IHP-GmbH/TO_Dec2024/README.md

## Sample request process

The December 2024 run is out of the fab, so you can now ask for samples.

### What you must do

1. Sign the Hiring Agreement: [samples.rtf](https://github.com/IHP-GmbH/TO_Sep2025/blob/main/drc/samples.rtf) (download i
2. Send the signed file by email to:
   - **herman(at)ihp-microelectronics.com**
   - **nkehder(at)ihp-microelectronics.com**

### Required data in your email

Please include all contact details:

- **Name Last Name**
- **Address**
- **Phone number**
- **Email**

### Packaging options and bonding plan

- By default, we send **10 bare dies**.
- If you need a packaged chip, we can offer **QFN** or **open QFN** with pin counts from **24 to 64**.
- For bonding, we need a bonding plan.

| Design name | Short one line description | Location directory |
| --- | --- | --- |
| Three SiGe HBT amplifiers (`FMD_QNC_amps_filled`) | Three SiGe HBT low-power amplifiers, a 3.3 V shunt regulator, and RF test structures on IHP SG13G2. | `RF_amplifiers/` |
