IHP-GmbH/TO_Dec2024/RF_amplifiers/doc/build/latex/pinout-eps-converted-to.pdf

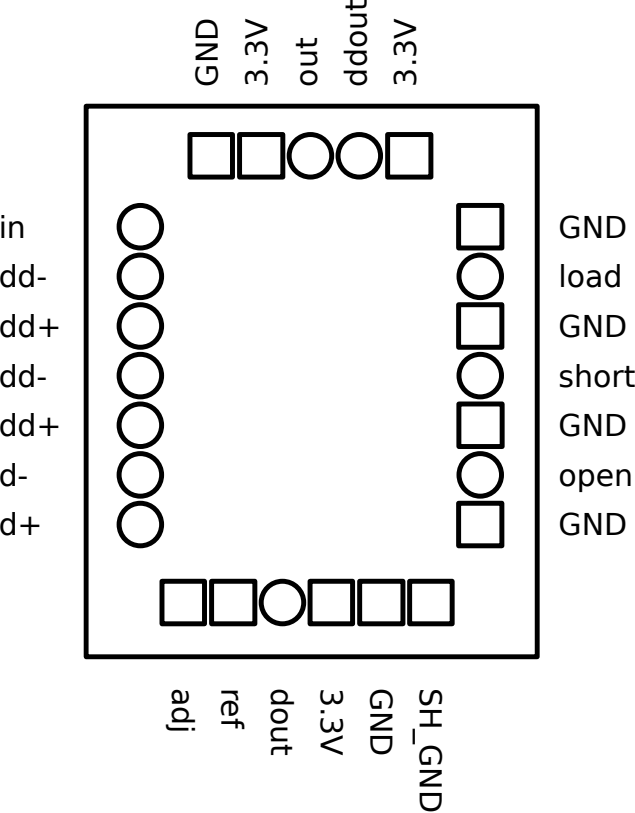
[picture p5: figure]
GND; load; short; open; out; ddout; adj; ref; dout; SH_GND
