IHP-GmbH/TO_Dec2024/RF_amplifiers/doc/source/_static/amplifiers_TB_xyce.pdf

/ALL/git_olisnr/TO_Dec2024/RF_amplifiers/design_data/xschem/amplifiers/amplifiers_TB_xyce.sch

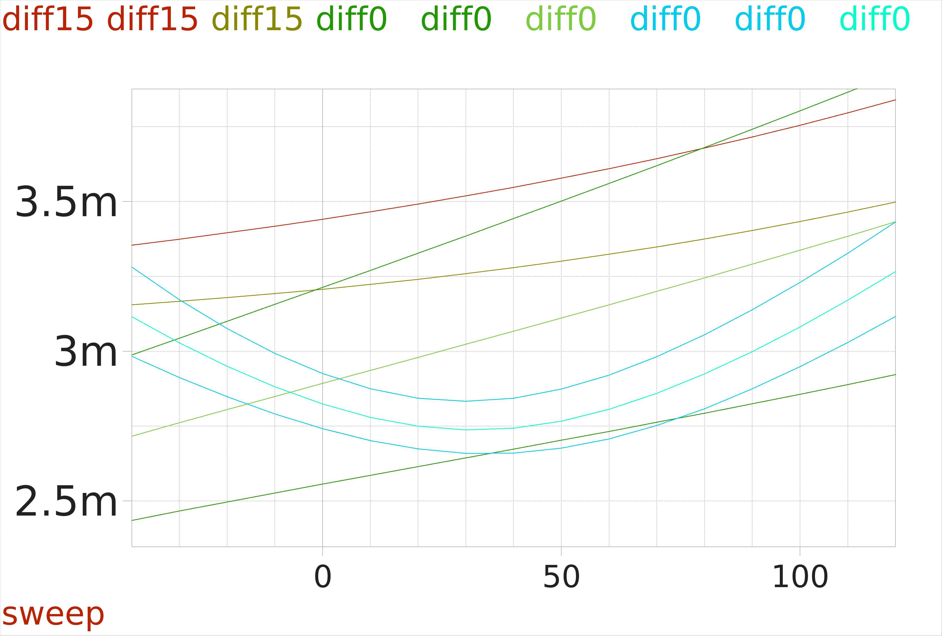
[picture p6: figure]

signal

VSS

VDD

GNDGND

GND

GND

0

h_single

GND

GND

signal

VDD

VSS

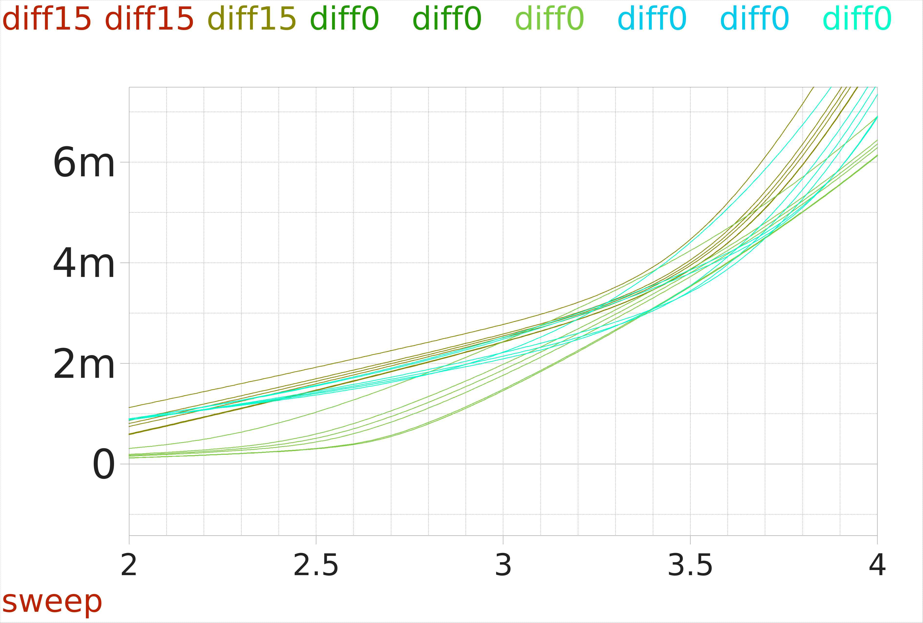
[picture p7: figure]

h_diff_0dB_cm

GND

signal

h_diff_0dB

GND

GND

signal

signal

VDD

VDD

VDD

VDD

VSS

VSS

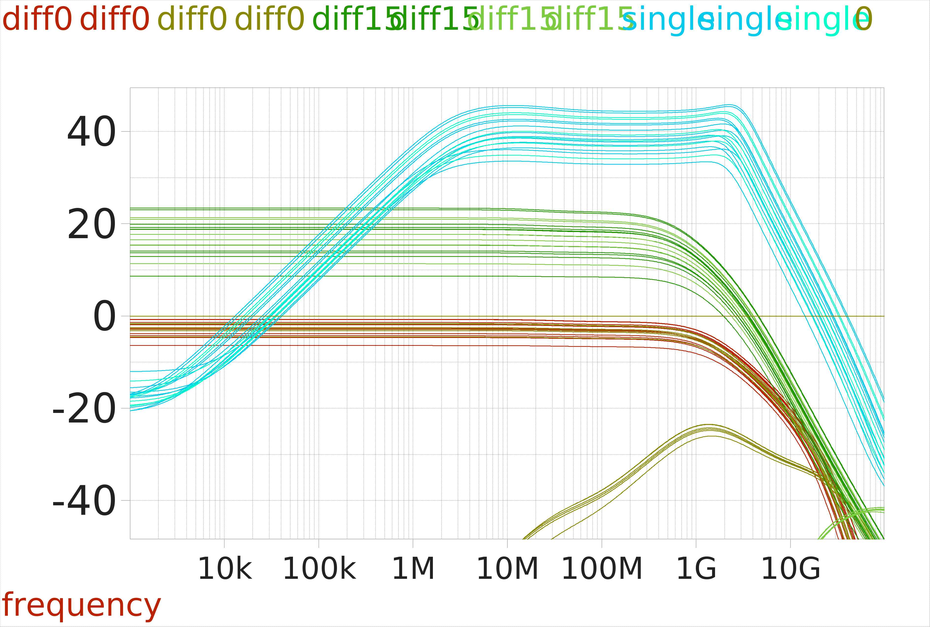
[picture p8: figure]

h_diff_15dB_cm

GND

signal

h_diff_15dB

GND

GND

signal

signal

VDD

VDD

VDD

VDD

VSS

VSS

VDD

/ALL/git_olisnr/TO_Dec2024/RF_amplifiers/design_data/xschem/amplifiers/amplifiers_TB_xyce.sch

om | 2024-12-14 23:22:29 SCHEM

VDD

3.3

VMINUS

0 pulse -100m 100m 1u 10n 10n 33u 66u ac 1 0

VSS

0

COMMANDS1

pdk_path = /home/ich/share/pdk/ihp-sg13g2

mosfet corners: tt ss ff sf fs
mosfet corners: tt
hbt corners: wcs typ bcs

simulations: op dc dc_zoom ac tran simulations: op dc ac temp

ac 1003..100e9Hz;

# pmos w/l = 2u/1u dont work for TCL # nmos w/l = 1u/1u dont work for TCL pmos w/l = 2e-6/1e-6

nmos w/l = 1e-6/1e-6

#proc to ignore simulator=none evaluation for ngspice

.raw-file path and namebase: /ALL/git_olisnr/TO_Dec2024/RF_amplifiers/design_data/xschem/amplifiers/simulation/amplifiers_TB_xyce

SIM=none

NGSPiCE TCL
SIM=ngspice

### load waves

* schematic: amplifiers_TB_xyce
* dir: | /ALL/git_olisnr/TO_Dec2024/RF_amplifiers/design_data/xschem/amplifiers
* test: | /ALL/git_olisnr/TO_Dec2024/RF_amplifiers/design_data/xschem/amplifiers/OTA33_BiAS.sym
.lib /home/ich/share/pdk/ihp-sg13g2/libs.tech/xyce/models/cornerRES.lib | res_typ
.lib /home/ich/share/pdk/ihp-sg13g2/libs.tech/xyce/models/cornerCAP.lib | cap_typ
.lib /home/ich/share/pdk/ihp-sg13g2/libs.tech/xyce/models/cornerMOShv.lib | mos_tt
.lib /home/ich/share/pdk/ihp-sg13g2/libs.tech/xyce/models/cornerMOSlv.lib | mos_tt
.lib /home/ich/share/pdk/ihp-sg13g2/libs.tech/xyce/models/cornerHBT.lib | hbt_bcs

.print dc format=raw v(*) i(*)

Xyce TCL
SIM=xyce

Vzero

0

### xyce netlist simulate corners ALL

Xyce
SIM=xyce

### xschem annotate_op

/ALL/git_olisnr/TO_Dec2024/RF_amplifiers/design_data/xschem/amplifiers/H_SiNGLE.sch

x12

VDD

ip

in

VSS

nmos: 1e-06/1e-06

pmos: 2e-06/1e-06sink #net1#net4
h_single

#net2

#net5

#net3

CGND

vGND
#net29

I12
{iset}

1

E5

Vsingle

Vsingle_all

/ALL/git_olisnr/TO_Dec2024/RF_amplifiers/design_data/xschem/amplifiers/DiFF_0dBdB.sch

x1

VDD

ip

in

VSS

nmos: 1e-06/1e-06

pmos: 2e-06/1e-06sink #net6#net14
h_diff_0dB_cm

#net9

#net9

#net13

CGND

vGND
#net30

I1
{iset}

/ALL/git_olisnr/TO_Dec2024/RF_amplifiers/design_data/xschem/amplifiers/DiFF_0dBdB.sch

x2

VDD

ip

in

VSS

nmos: 1e-06/1e-06

pmos: 2e-06/1e-06sink #net7#net15
h_diff_0dB

#net8

#net16

#net12

CGND

vGND
#net31

I2
{iset}

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
VLD1

1.65

VLD2

1.65

Vdiff0

Vmeas2

Vmeas3

Vdiff0_all

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
/ALL/git_olisnr/TO_Dec2024/RF_amplifiers/design_data/xschem/amplifiers/H_DiFF_15dB.sch

x3

VDD

ip

in

VSS

nmos: 1e-06/1e-06

pmos: 2e-06/1e-06sink #net17#net25
h_diff_15dB_cm

#net20

#net20

#net24

CGND

vGND
#net32

I3
{iset}

/ALL/git_olisnr/TO_Dec2024/RF_amplifiers/design_data/xschem/amplifiers/H_DiFF_15dB.sch

x4

VDD

ip

in

VSS

nmos: 1e-06/1e-06

pmos: 2e-06/1e-06sink #net18#net26
h_diff_15dB

#net19

#net27

#net23

CGND

vGND
#net33

I4
{iset}

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
VLD3

1.65

VLD4

1.65

Vdiff15

Vmeas6

Vmeas7

Vdiff15_all

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
VLD5

1.65

1

2

R9
50
m=1

loaded .raw files:
0 current
0 1 /ALL/git_olisnr/TO_Dec2024/RF_amplifiers/design_data/xschem/amplifiers/simulation/amplifiers_TB_xyce_ac_mostt_hbttyp.spice.raw ac 2 /ALL/git_olisnr/TO_Dec2024/RF_amplifiers/design_data/xschem/amplifiers/simulation/amplifiers_TB_xyce_ac_mostt_hbtwcs.spice.raw ac 3 /ALL/git_olisnr/TO_Dec2024/RF_amplifiers/design_data/xschem/amplifiers/simulation/amplifiers_TB_xyce_ac_mostt_hbtbcs.spice.raw ac 4 /ALL/git_olisnr/TO_Dec2024/RF_amplifiers/design_data/xschem/amplifiers/simulation/amplifiers_TB_xyce_dc_mostt_hbttyp.spice.raw dc
5 /ALL/git_olisnr/TO_Dec2024/RF_amplifiers/design_data/xschem/amplifiers/simulation/amplifiers_TB_xyce_temp_mostt_hbttyp.spice.raw dc 6 /ALL/git_olisnr/TO_Dec2024/RF_amplifiers/design_data/xschem/amplifiers/simulation/amplifiers_TB_xyce_temp_mostt_hbtbcs.spice.raw dc 7 /ALL/git_olisnr/TO_Dec2024/RF_amplifiers/design_data/xschem/amplifiers/simulation/amplifiers_TB_xyce_temp_mostt_hbtwcs.spice.raw dc
