IHP-GmbH/TO_Dec2024/RF_amplifiers/doc/source/index.rst

##########################################
Three SiGe HBT amplifiers
##########################################

.. warning::
    this chip is designed without correct LVS. only parts are really verified...

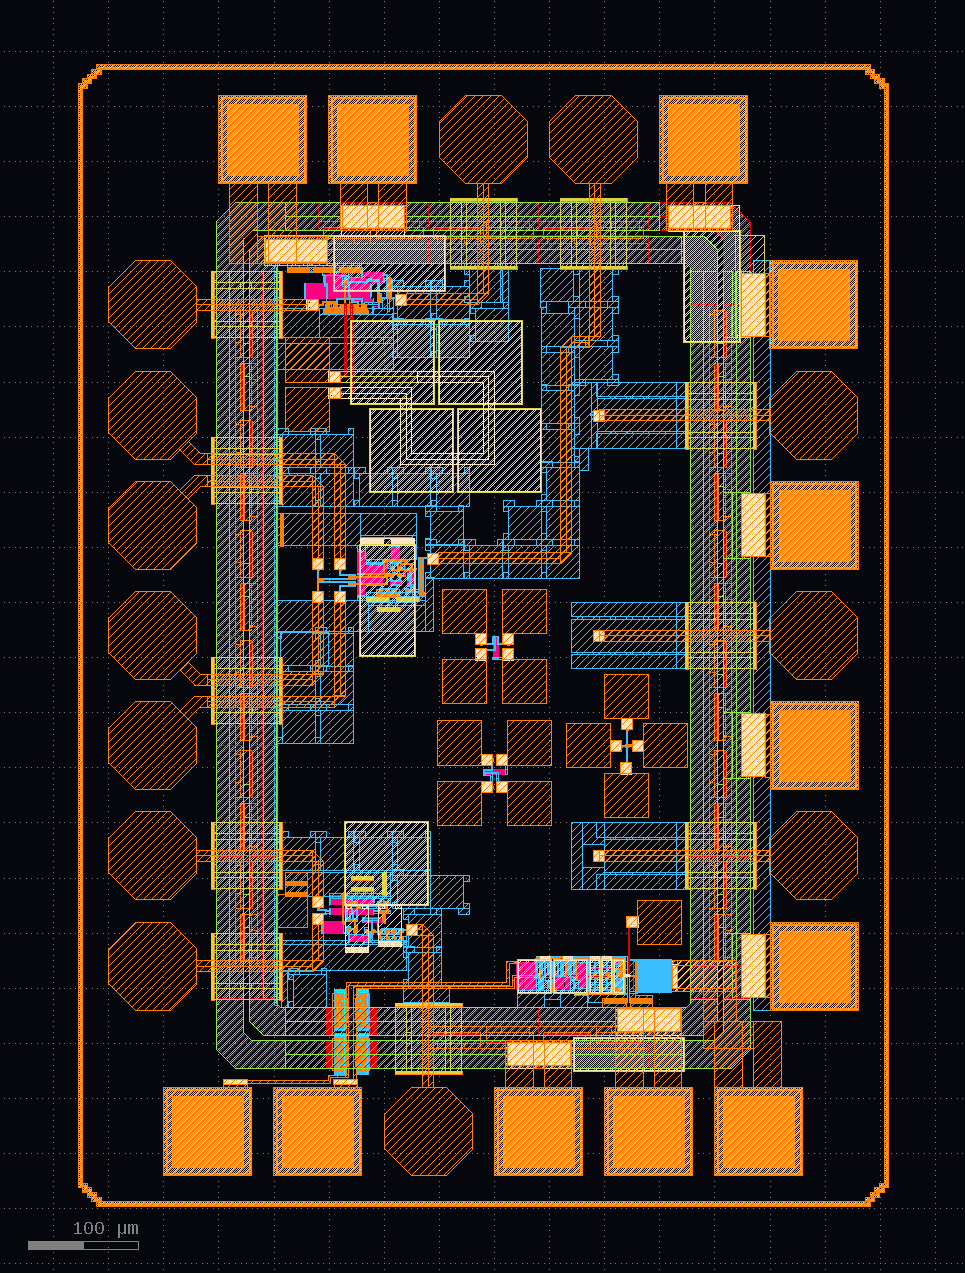
[picture p9: RF_amplifiers/doc/source/_static/chip.png]


\

.. toctree::
    :hidden:
    
    specification
    amplifiers
    regulator
    ota
    experiments
    designdata
    validation

.. only:: latex

    .. contents:: Table of Contents
