IHP-GmbH/TO_Dec2024/RF_amplifiers/doc/source/_static/SHUNT_3V1.pdf

# /ALL/git_olisnr/TO_Dec2024/RF_amplifiers/design_data/xschem/shunt_regulator/SHUNT_3V1.sch

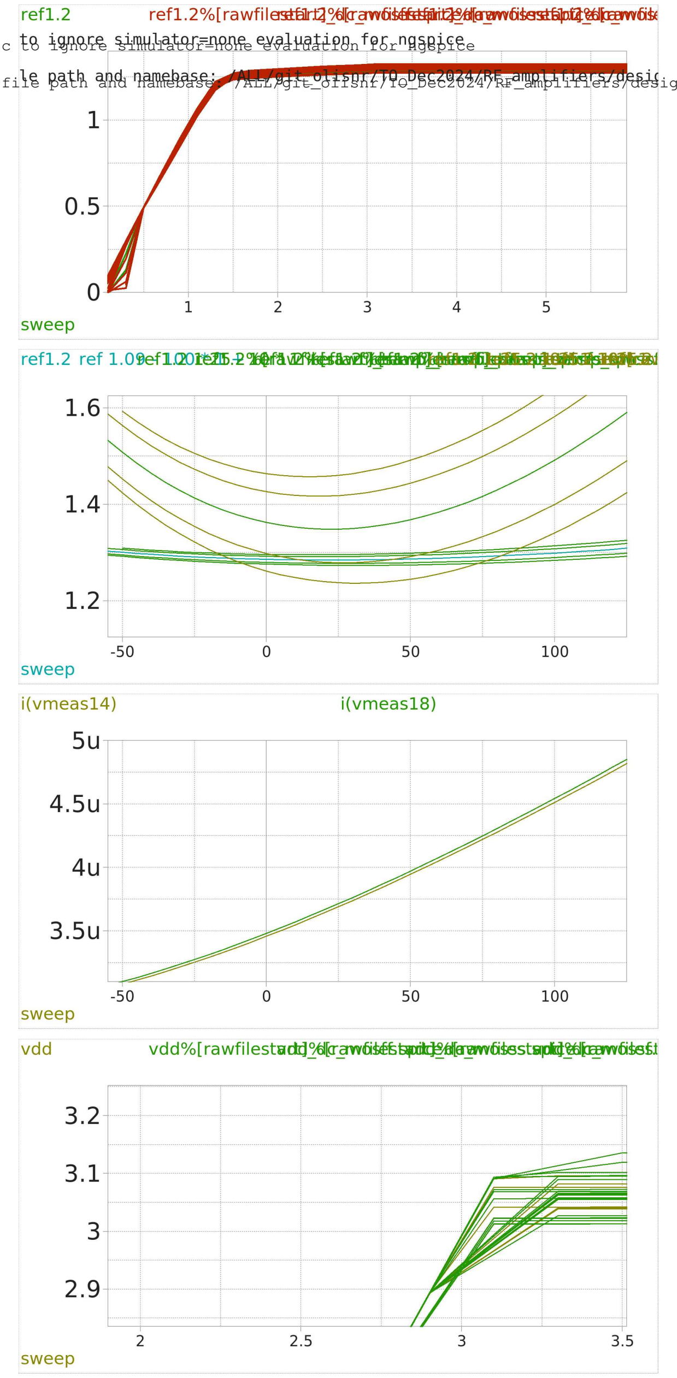
[picture p10: figure]
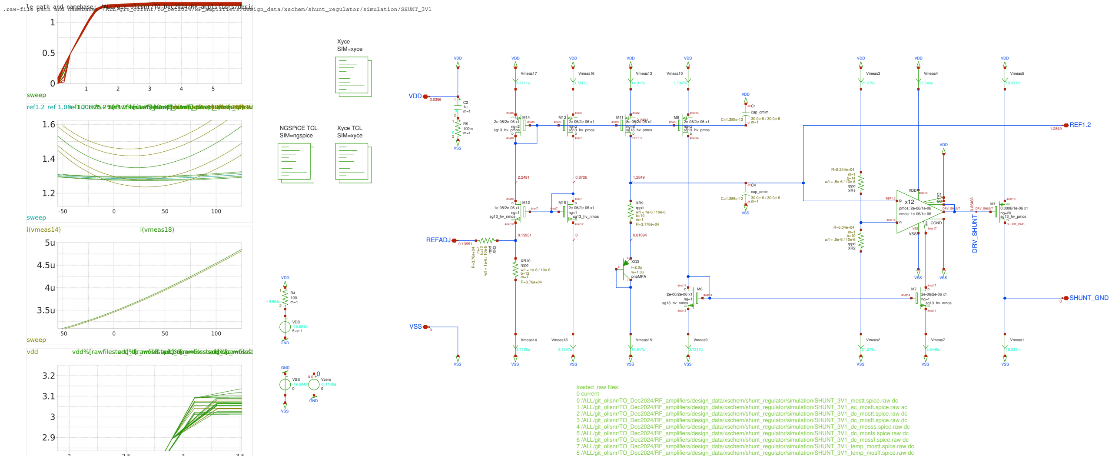
[picture p11: figure]
VSS; GND; VDD; VDDVDD; VSSVSS; DRV_SHUNT 0.85468; REFADJ; REF1.2; SHUNT_GND 0; .raw-file path and namebase: /ALL/git_olisnr/TO_Dec2024/RF_amplifiers/design_data/xschem/shunt_regulator/simulation/SHUNT_3V1; NGSPiCE TCL SIM=ngspice; Xyce TCL SIM=xyce; Vzero; Xyce SIM=xyce; Vmeas13; sg13_hv_pmos; #net2; #net8; Vmeas14; Vmeas15; pnpMPA; sg13_hv_nmos; #net10; #net7; #net5; #net6; Vmeas16; Vmeas17; Vmeas18; #net12; rppd; Vmeas7; #net17; #net11; #net14; Vmeas9; #net13; Vmeas10; #net15; SHUNT_GND; #net18; DRV_SHUNT; nmos: 1e-06/1e-06; pmos: 2e-06/1e-06sink #net17VSS; #net16; #net19; CGND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

### /ALL/git_olisnr/TO_Dec2024/RF_amplifiers/design_data/xschem/shunt_regulator/SHUNT_3V1.sch

om | 2024-12-14 23:22:29 SCHEM

COMMANDS1

amp schematics = /ALL/git_olisnr/TO_Dec2024/RF_amplifiers/design_data/xschem/shunt_regulator/hAMPsdiff_3.5mA_15dB.sch

pdk_path = /home/ich/share/pdk/ihp-sg13g2

mosfet corners: tt ss ff sf fs

simulations: op dc dc_zoom ac tran simulations: op dc ac temp

iset: 3u

ac 100e3..100e9Hz;

# pmos w/l = 2u/1u dont work for TCL # nmos w/l = 1u/1u dont work for TCL pmos w/l = 2e-6/1e-6

nmos w/l = 1e-6/1e-6

G = 33
Y = 11
A = 1
B = 1
C = 1

#proc to ignore simulator=none evaluation for ngspice

SIM=none

### load waves

COMMANDS3

spice code

* schematic: SHUNT_3V1
* dir: | /ALL/git_olisnr/TO_Dec2024/RF_amplifiers/design_data/xschem/shunt_regulator
* test: | /ALL/git_olisnr/TO_Dec2024/RF_amplifiers/design_data/xschem/shunt_regulator/OTA33_BiAS.sym

* mos_corner:
* mos_corner:

.option temp=27

.lib /home/ich/share/pdk/ihp-sg13g2/libs.tech/xyce/models/cornerRES.lib | res_typ
.lib /home/ich/share/pdk/ihp-sg13g2/libs.tech/xyce/models/cornerCAP.lib | cap_typ
.lib /home/ich/share/pdk/ihp-sg13g2/libs.tech/xyce/models/cornerMOShv.lib | mos_fs
.lib /home/ich/share/pdk/ihp-sg13g2/libs.tech/xyce/models/cornerMOSlv.lib | mos_fs
.lib /home/ich/share/pdk/ihp-sg13g2/libs.tech/xyce/models/cornerHBT.lib | hbt_typ

.param nw=1e-6
.param nl=1e-6
.param pw=2e-6
.param pl=1e-6
.param iset=3u

* .step dec iset 10u 100u 3

.dc temp -55 125 5
.print dc format=raw v(*) i(*)

SIM=none

### xschem annotate_op

### xyce netlist simulate corners ALL

### write LVS netlist

# AC Analysis

8 /ALL/git_olisnr/TO_Dec2024/RF_amplifiers/design_data/xschem/shunt_regulator/simulation/SHUNT_3V1_temp_mosff.spice.raw dc 9 /ALL/git_olisnr/TO_Dec2024/RF_amplifiers/design_data/xschem/shunt_regulator/simulation/SHUNT_3V1_temp_mosss.spice.raw dc 10 /ALL/git_olisnr/TO_Dec2024/RF_amplifiers/design_data/xschem/shunt_regulator/simulation/SHUNT_3V1_temp_mosfs.spice.raw dc 11 /ALL/git_olisnr/TO_Dec2024/RF_amplifiers/design_data/xschem/shunt_regulator/simulation/SHUNT_3V1_temp_mossf.spice.raw dc
