IHP-GmbH/TO_Dec2024/RF_amplifiers/doc/source/experiments.rst

####################
experiments
####################

RPPD
#########

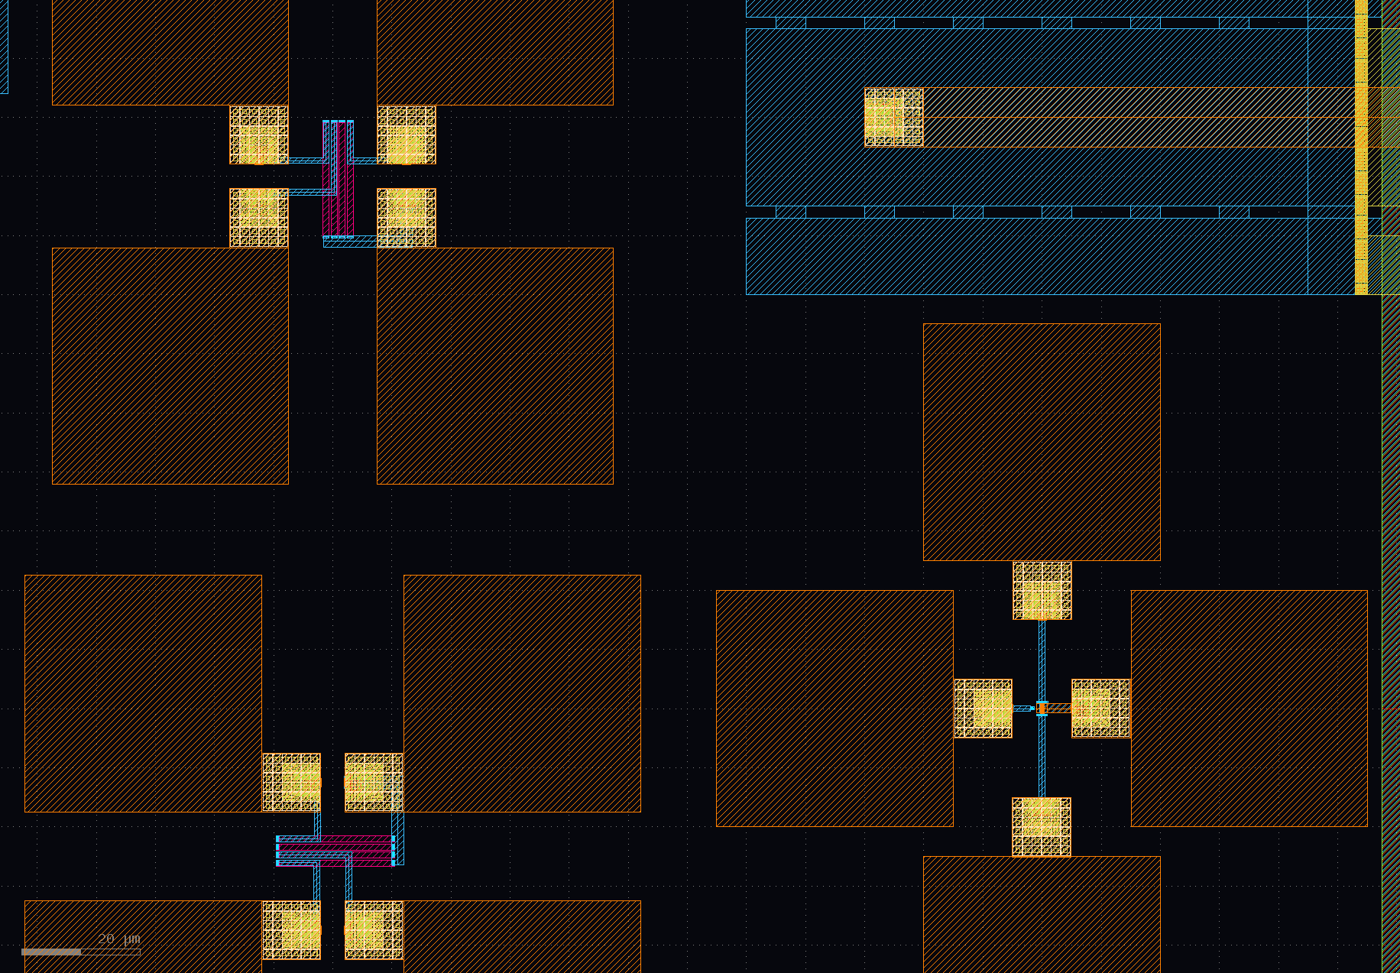
[picture p22: RF_amplifiers/doc/source/_static/exp_layout.png]


there are 6 resistors available to measure: 
3 in X and Y orientations
and both versions as dummy and normal resistors

sg13g2
#######

there is a fast BjT for measurements.

calibration kit
###############

to measure the amplifier impedances and to see the effect of pads and wire-bonding, there are an open, short and load calkit.
