IHP-GmbH/TO_Dec2024/RF_amplifiers/doc/source/validation.rst

#################################
validation of the circuits
#################################

asap & subito...
