IHP-GmbH/TO_Dec2024/RF_amplifiers/doc/source/_static/OTA33_test_01_xyce.pdf

# /ALL/Xschem/OTA33.xyce/OTA33_test_01_xyce.sch

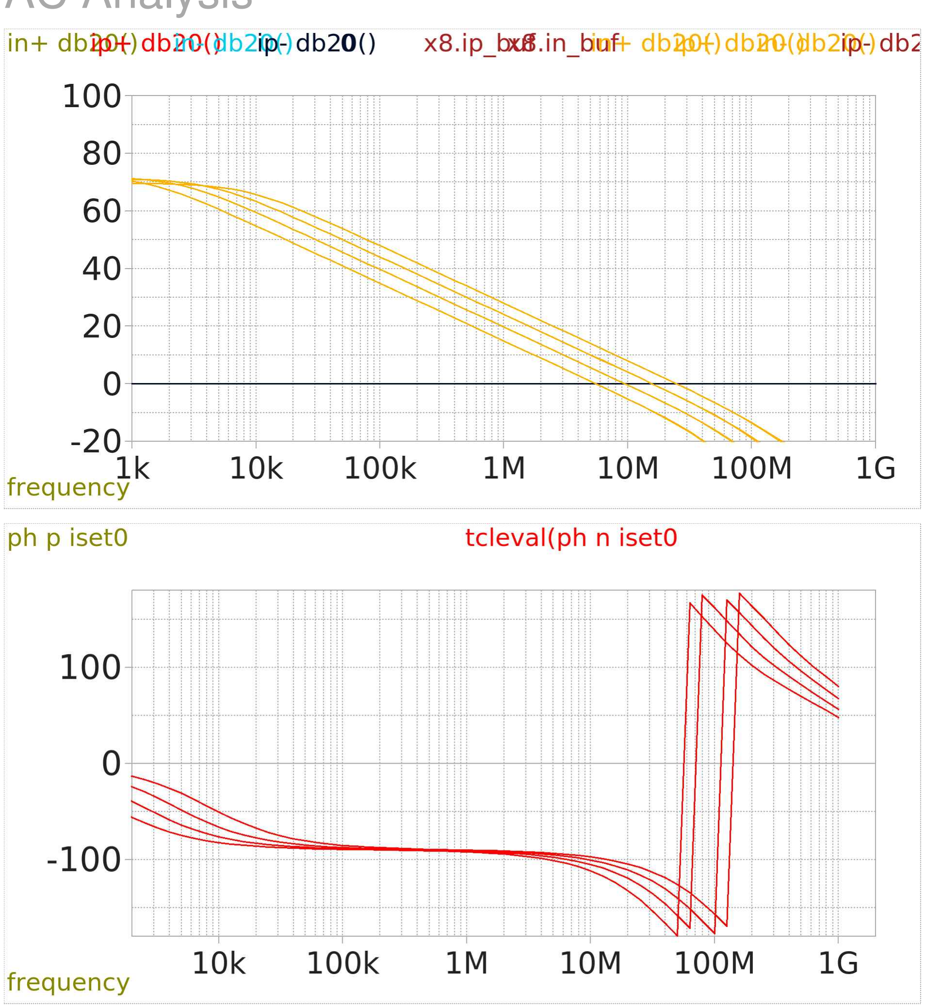
[picture p23: figure]
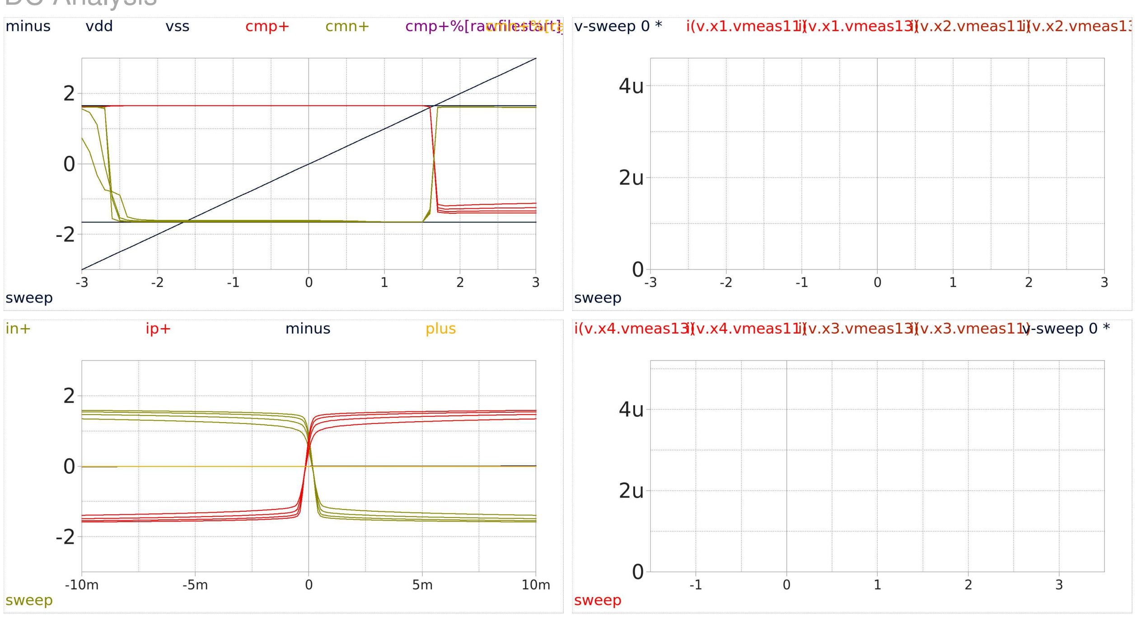
[picture p24: figure]

### PLUS

### MINUS

### PLUS

### MINUS

### PLUS

### MINUS

### MINUS

### MINUS

VSS

VDD

GND

GND

VSSb

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
VDDa

VSS

VDD

VSSb

VSS

VDDa

VDD

in+

ip+

### cmn+

### cmp+

### pdd+

### pss+

### MINUS

VSS

### follow+

GND

GND

GND

GND

GND

GND

GND

### MINUS

VSS

### invert+

GND

GND

GND

GND

GND

0

GND | GND

GND

GND

GND

GND

GND

GND

VDD | VDD

## /ALL/Xschem/OTA33.xyce/OTA33_test_01_xyce.sch

om | 2024-11-29 17:35:06 SCHEM

VDD

1.65

VPLUS1

50m VPLUS2

50m

50m

VPLUS3

VPLUS4

50m

VPLUS

0

VMINUS

0 pulse -100m 100m 1u 10n 10n 33u 66u ac 1 0

VSS

1.65

VSSac

0 ac 1 0

VDDac1

0 ac 1 0

### COMMANDS1

pdk_path = /home/ich/share/pdk/ihp-sg13g2

mosfet corners: tt ss ff sf fs
mosfet corners: tt

simulations: op dc dc_zoom ac tran

iset: 3u

ac 1e3..1e9Hz;

# pmos w/l = 2u/1u dont work for TCL # nmos w/l = 1u/1u dont work for TCL pmos w/l = 2e-6/1e-6

nmos w/l = 1e-6/1e-6

#proc to ignore simulator=none evaluation for ngspice

.raw-file path and namebase: /ALL/Xschem/OTA33.xyce/simulation/OTA33_test_01_xyce

### SIM=none

### NGSPiCE TCL SIM=ngspice

## load waves

### COMMANDS3

spice code

* schematic: OTA33_test_01_xyce
* dir: | /ALL/Xschem/OTA33.xyce
* test: | /ALL/Xschem/OTA33.xyce/OTA33_BiAS.sym

* mos_corner:
* mos_corner:

.option temp=27

.lib /home/ich/share/pdk/ihp-sg13g2/libs.tech/xyce/models/cornerRES.lib | res_typ
.lib /home/ich/share/pdk/ihp-sg13g2/libs.tech/xyce/models/cornerCAP.lib | cap_typ
.lib /home/ich/share/pdk/ihp-sg13g2/libs.tech/xyce/models/cornerMOShv.lib | mos_tt
.lib /home/ich/share/pdk/ihp-sg13g2/libs.tech/xyce/models/cornerMOSlv.lib | mos_tt
.lib /home/ich/share/pdk/ihp-sg13g2/libs.tech/xyce/models/cornerHBT.lib | hbt_typ

.param nw=1e-6
.param nl=1e-6
.param pw=2e-6
.param pl=1e-6
.param iset=3u

.op
.print dc format=raw v(*) i(*)

### SIM=none

x7

VDD

ip

in

VSS

nmos: 1e-06/1e-06

pmos: 2e-06/1e-06

op

sink

#net5VSS

follow+

follow+

MINUS

#net15 | C1

C2
C3

x1

VDD

ip

in

VSS

nmos: 1e-06/1e-06

pmos: 2e-06/1e-06

op

sink

#net6VSS

in+

MINUS

PLUS

VDD | C1
C2
C3

x2

VDD

ip

in

VSS

nmos: 1e-06/1e-06

pmos: 2e-06/1e-06

op

sink

#net7VSS

ip+

PLUS

MINUS

VDD | C1
C2
C3

x3

VDD

ip

in

VSS

nmos: 1e-06/1e-06

pmos: 2e-06/1e-06

op

sink

#net8VSS

cmn+

#net2

#net1

VDD | C1
C2
C3

x4

VDD

ip

in

VSS

nmos: 1e-06/1e-06

pmos: 2e-06/1e-06

op

sink

#net9VSS

cmp+

#net3

#net4

VDD | C1
C2
C3

x6

VDD

ip

in

VSS

nmos: 1e-06/1e-06

pmos: 2e-06/1e-06

op

sink

#net10VSS

pdd+

GND

GND

VDDa | C1
C2
C3

x8

VDD

ip

in

VSS

nmos: 1e-06/1e-06

pmos: 2e-06/1e-06

op

sink

#net11VSSb

pss+

GND

GND

VDD | C1
C2
C3

I0
{iset}

I1
{iset}

I4
{iset}

I6
{iset}

I7
{iset}

I3
{iset}

I2
{iset}

x9

VDD

ip

in

VSS

nmos: 1e-06/1e-06

pmos: 2e-06/1e-06

op

sink

#net13VSS

invert+

#net12

GND

#net16 | C1

C2
C3

I5
{iset}

2

1 R9

m=1

100k

1

2

R10

100k
m=1

1

E1

### Xyce TCL SIM=xyce

Vzero

0

## xyce netlist simulate corners ALL

### Xyce SIM=xyce

## xschem annotate_op

1

2

C3
1a ic=0
m=1

1

2

C4
1a ic=0
m=1

1

2

C5
1a ic=0
m=1

1

2

C6
1a ic=0
m=1

1

2

C7
1a ic=0
m=1

1

2

C8
1a ic=0
m=1

1

2

C1
1a ic=0
m=1

1

2

C2
1a ic=0
m=1
Vmeas5 | Vmeas1

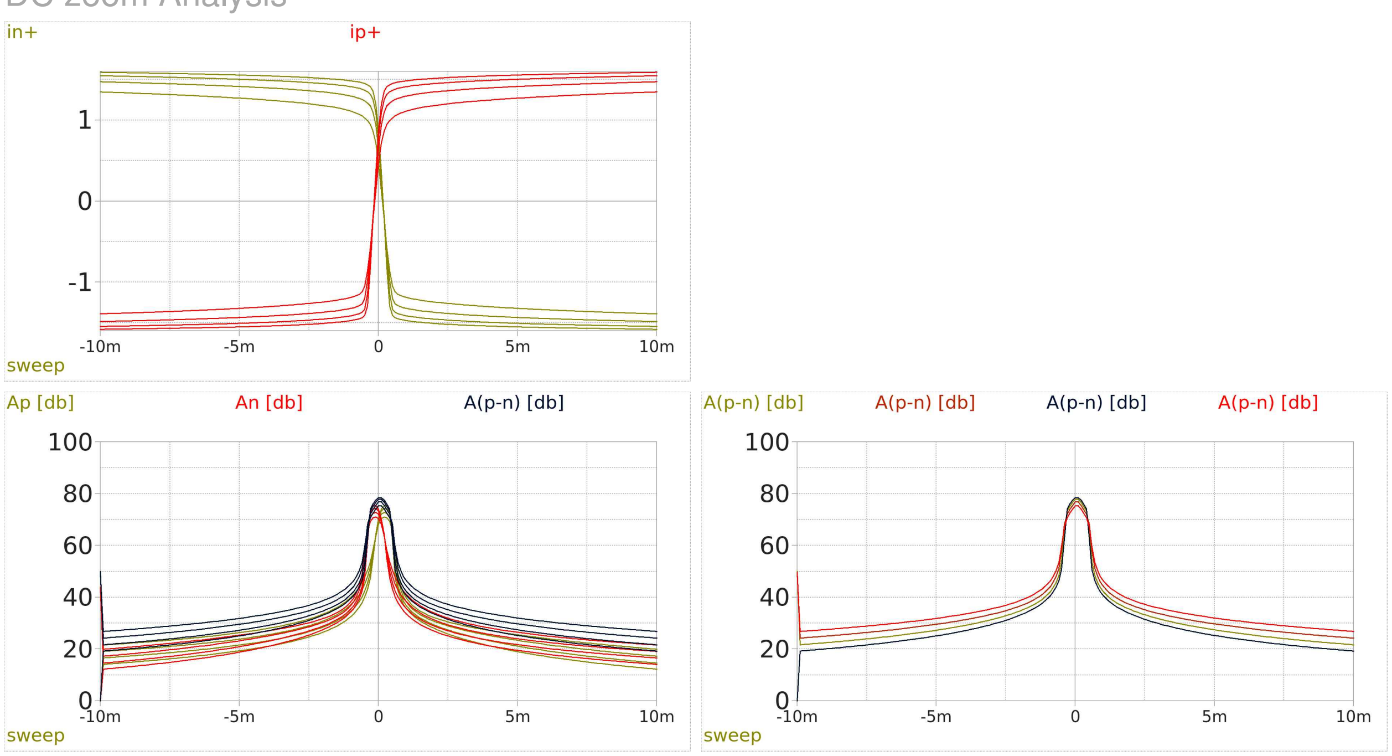
[picture p25: figure]

# Transient Analysis

# DC zoom Analysis

# DC AnalysisAC Analysis

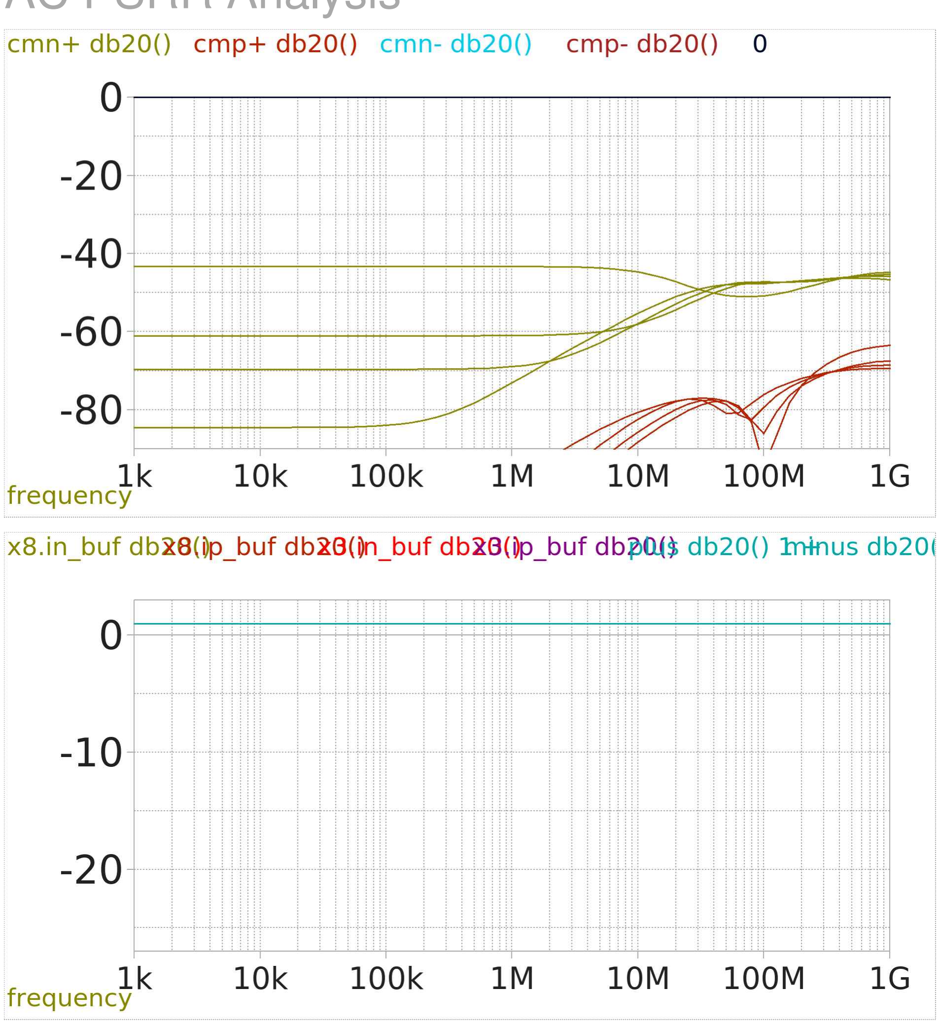
[picture p26: figure]

# AC CM Analysis

# AC PSRR Analysis

loaded .raw files: 0 current 0 /ALL/Xschem/OTA33.xyce/simulation/OTA33_test_01_xyce_dc_zoom_mostt.spice.raw dc 1 /ALL/Xschem/OTA33.xyce/simulation/OTA33_test_01_xyce_dc_mostt.spice.raw dc 2 /ALL/Xschem/OTA33.xyce/simulation/OTA33_test_01_xyce_ac_mostt.spice.raw ac 3 /ALL/Xschem/OTA33.xyce/simulation/OTA33_test_xyce_dc_mostt.spice.raw dc 4 /ALL/Xschem/OTA33.xyce/simulation/OTA33_test_01_xyce_tran_mostt.spice.raw tran
