IHP-GmbH/TO_Dec2024/RF_amplifiers/doc/build/latex/OTA33_BiAS-eps-converted-to.pdf

## VDD

V++

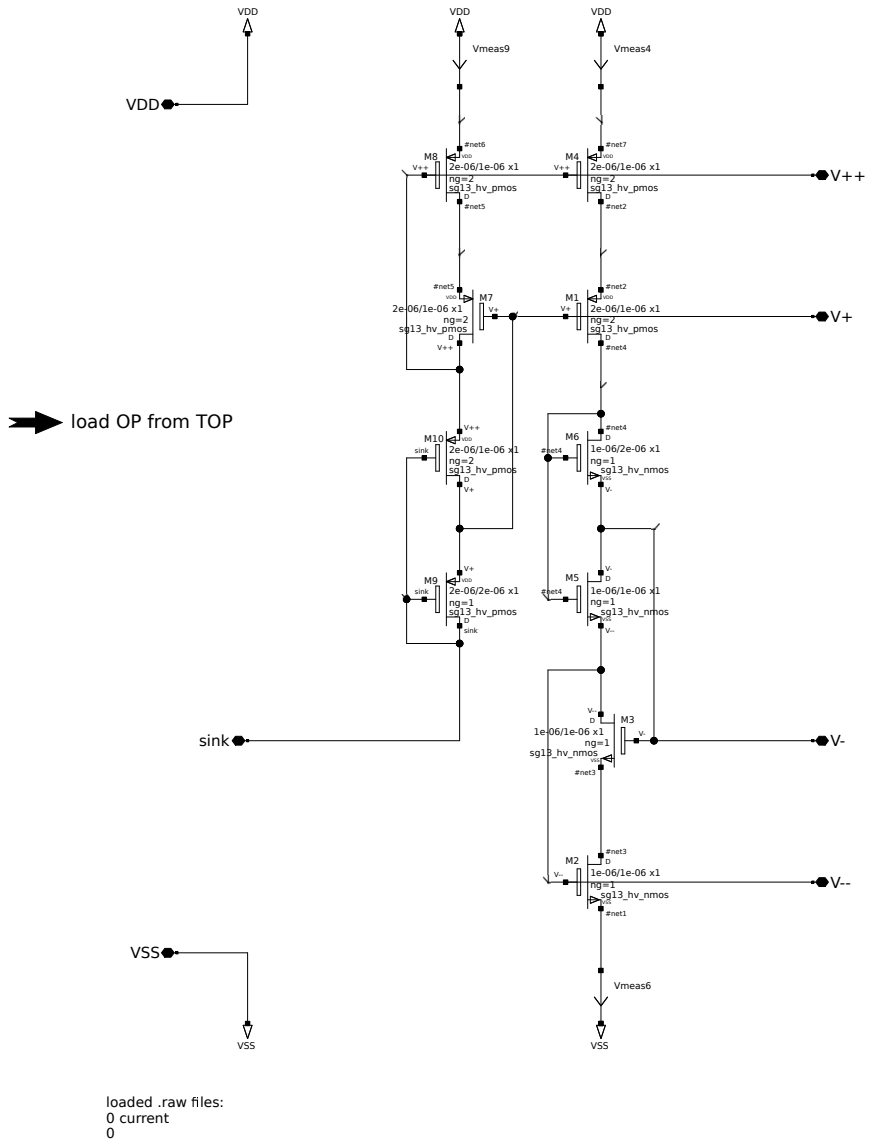
[picture p27: page 1]
VSS; VDD; sink; sg13_hv_pmos D; #net4; #net2; Vmeas4; Vmeas6; sg13_hv_nmos; #net3; #net1; #net7; #net5; #net6; Vmeas9; loaded .raw les: 0 current 0

load OP from TOP
