IHP-GmbH/TO_Dec2024/RF_amplifiers/doc/build/latex/d0-eps-converted-to.pdf

# write LVS netlist

# xschem annotate_op

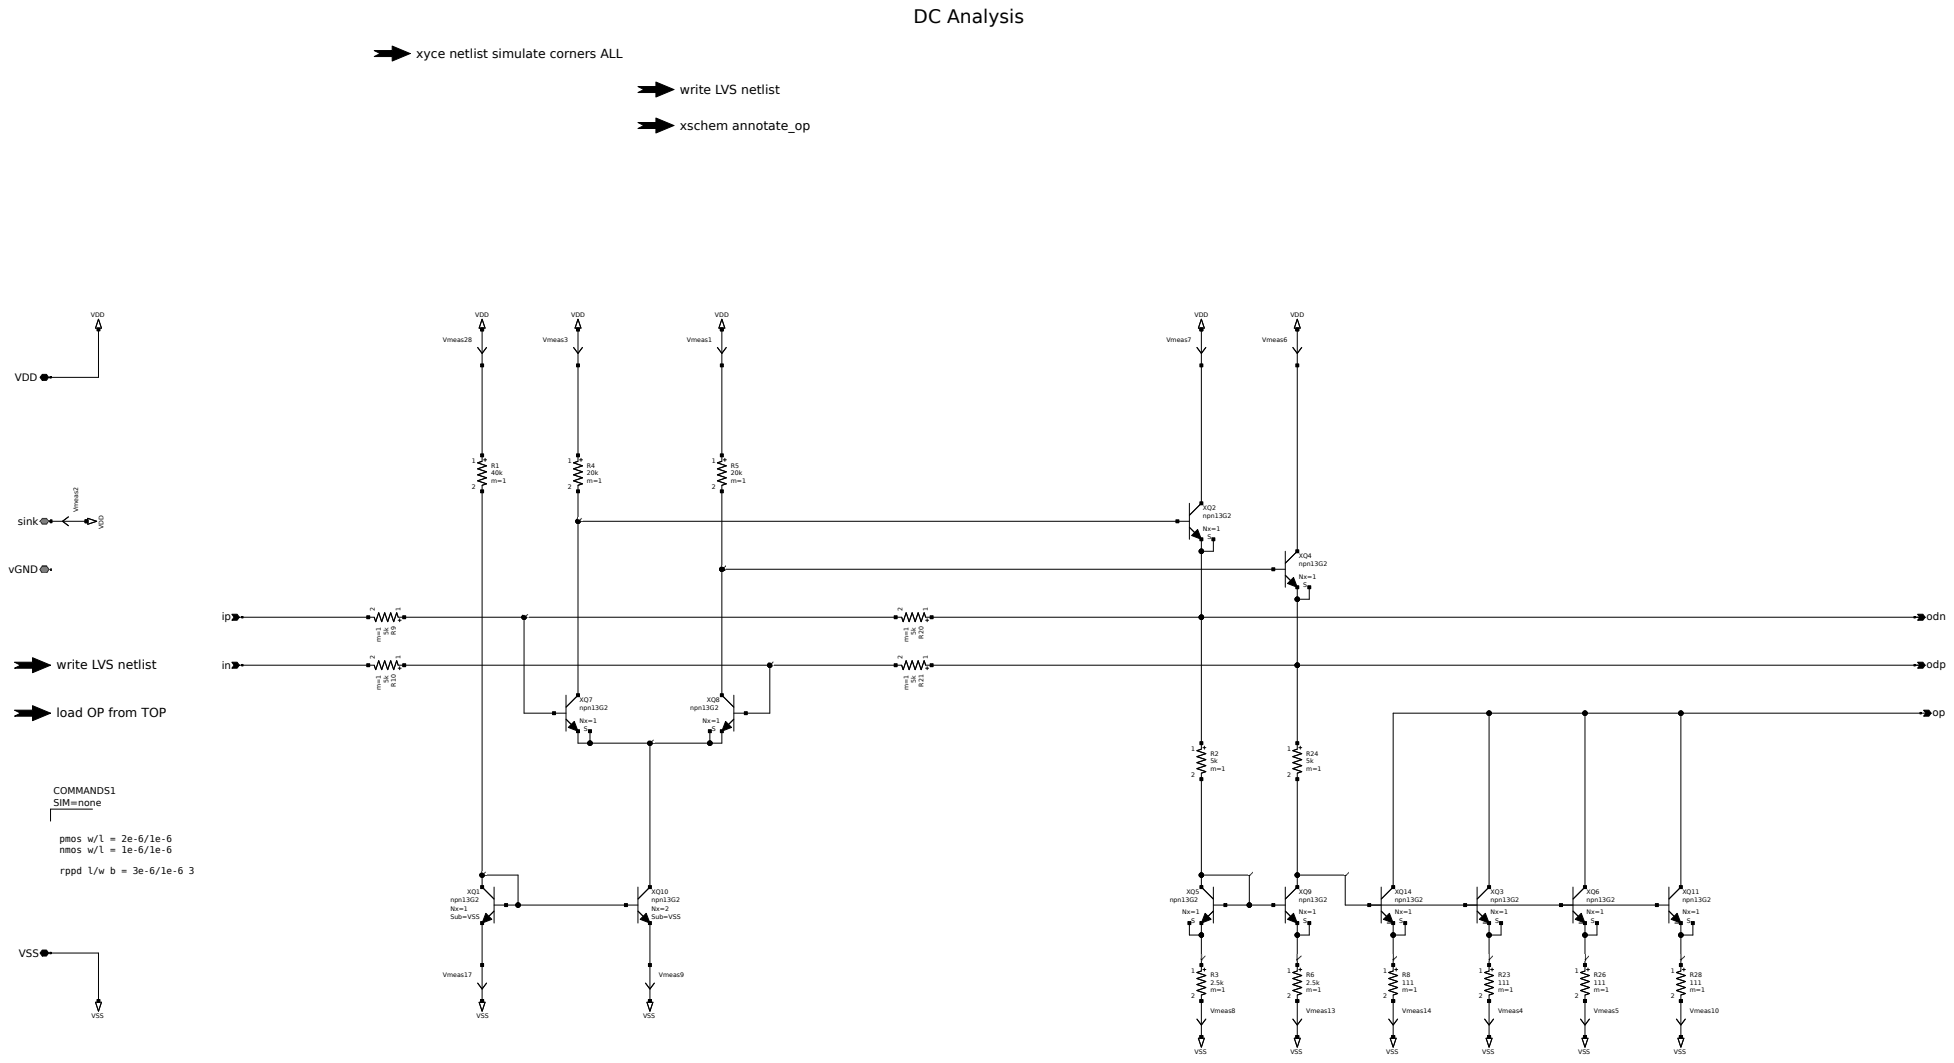
[picture p28: page 1]

xyce netlist simulate corners ALL

load OP from TOP
