IHP-GmbH/TO_Dec2024/RF_amplifiers/doc/build/latex/d15-eps-converted-to.pdf

## VDD

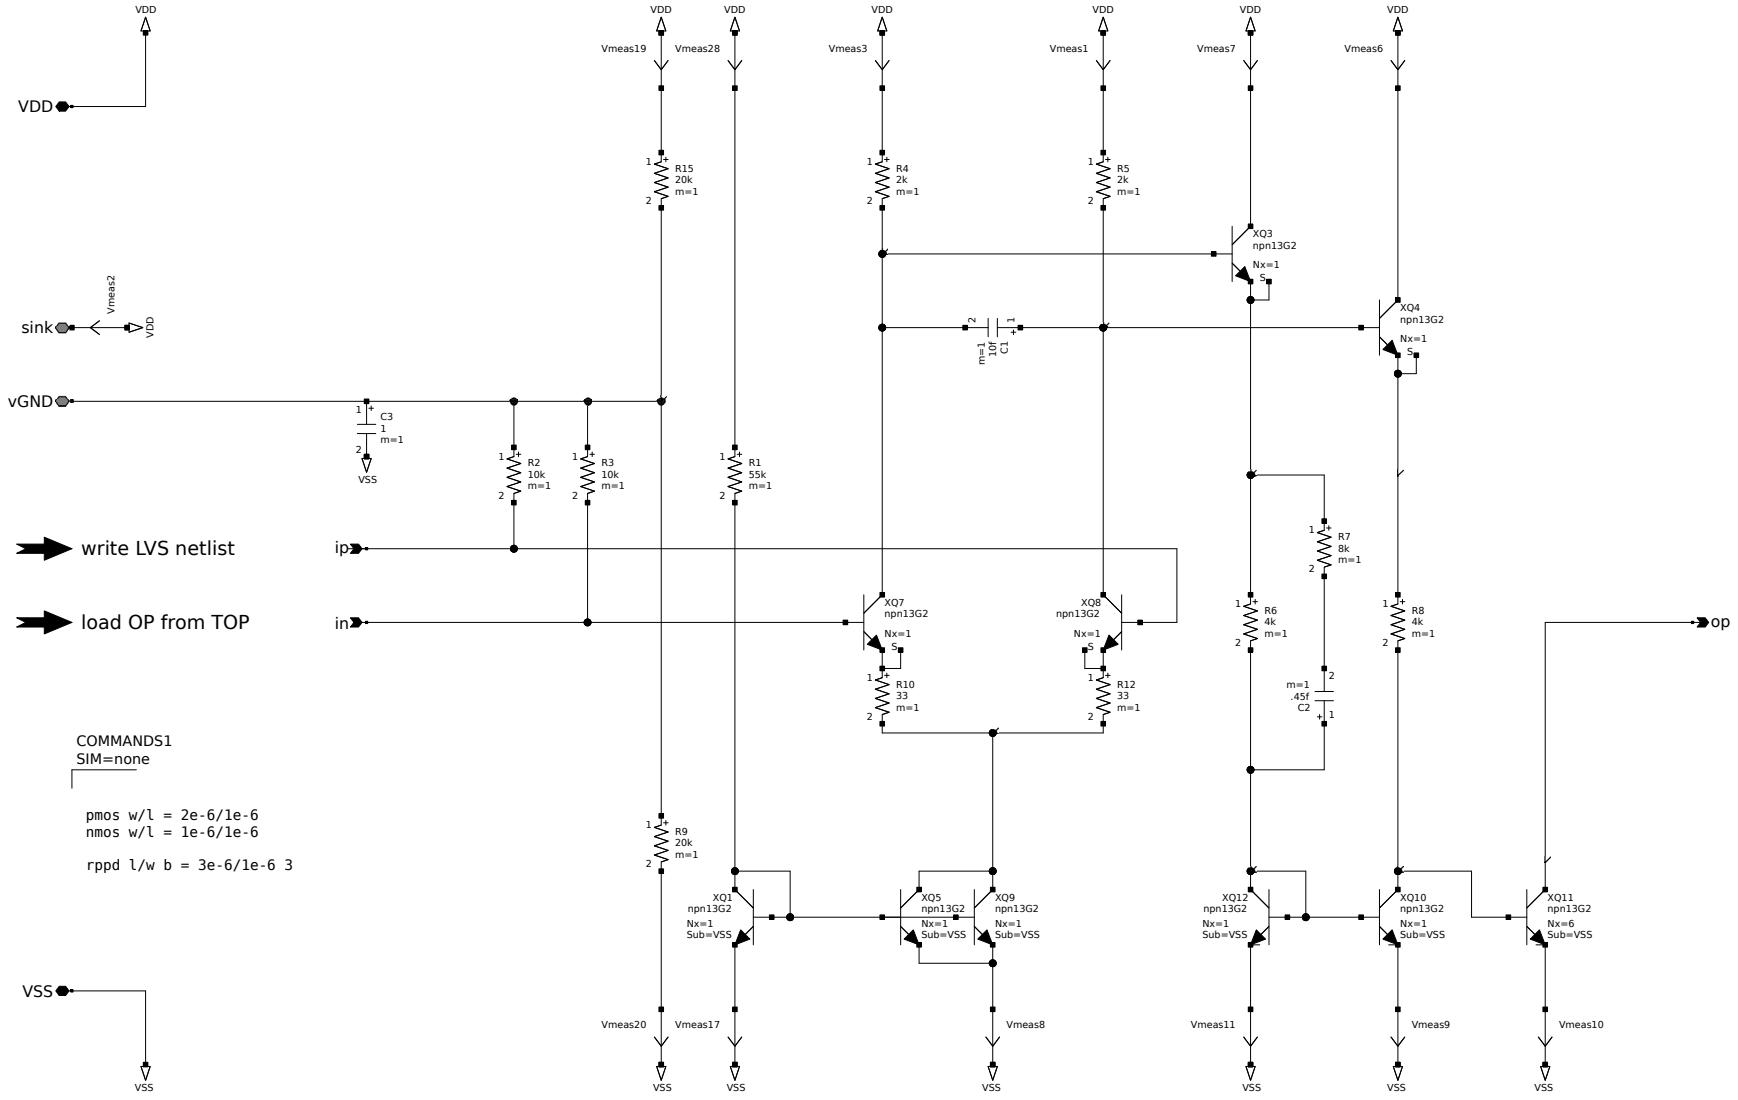
[picture p29: page 1]

load OP from TOP
