IHP-GmbH/TO_Dec2024/RF_amplifiers/doc/build/latex/OTA3C-eps-converted-to.pdf

## VDD

## COMMANDS1

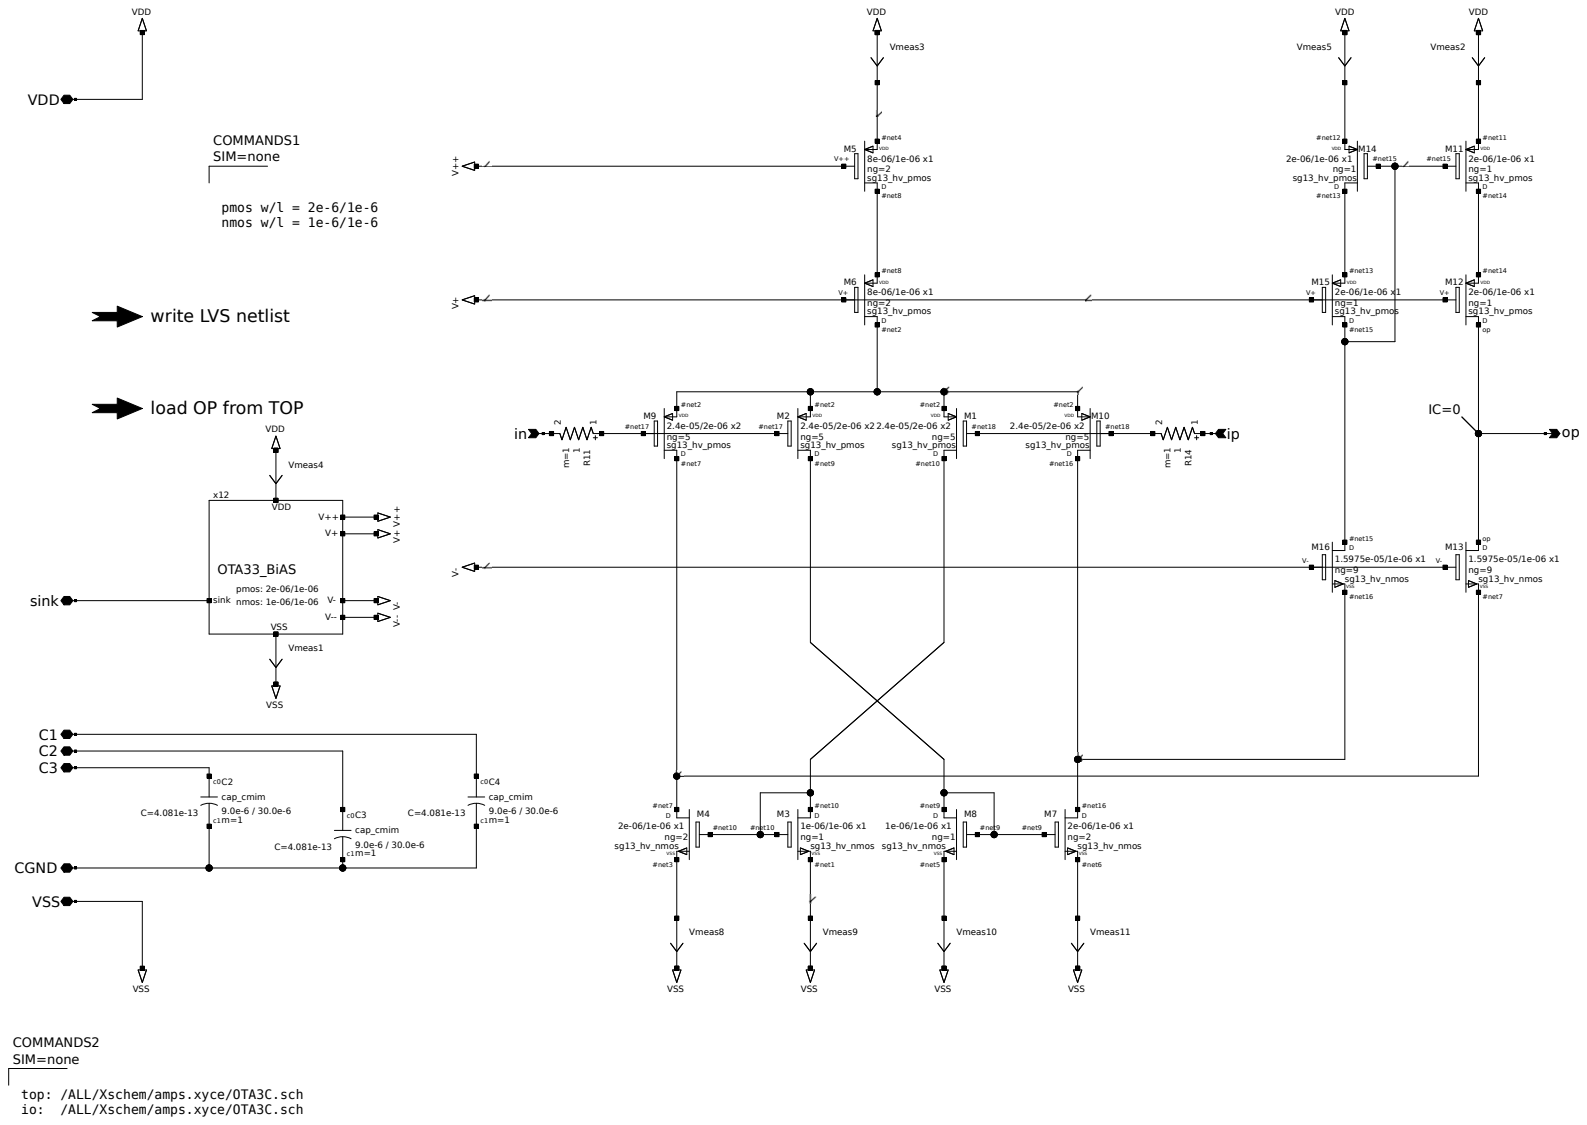
[picture p30: page 1]
VSS; VDD; sink; VDDVDD; CGND; sg13_hv_pmos; #net10; #net2; #net18; #net9; #net17; Vmeas3; sg13_hv_nmos; #net1; #net7; #net3; Vmeas8; Vmeas9; #net8; #net4; COMMANDS2; /ALL/Xschem/amps.xyce/OTA3C.sch; SIM=none; #net16; #net6; #net5; Vmeas10; Vmeas11; Vmeas2; #net14; #net11; #net15; Vmeas5; #net13; #net12; OTA33_BiAS; nmos: 1e-06/1e-06; pmos: 2e-06/1e-06; Vmeas1; Vmeas4; pmos w/l = 2e-6/1e-6 nmos w/l = 1e-6/1e-6; cap_cmim; load OP from TOP

write LVS netlist

top: /ALL/Xschem/amps.xyce/OTA3C.sch
