IHP-GmbH/TO_Dec2024/RF_amplifiers/doc/build/latex/shunt-eps-converted-to.pdf

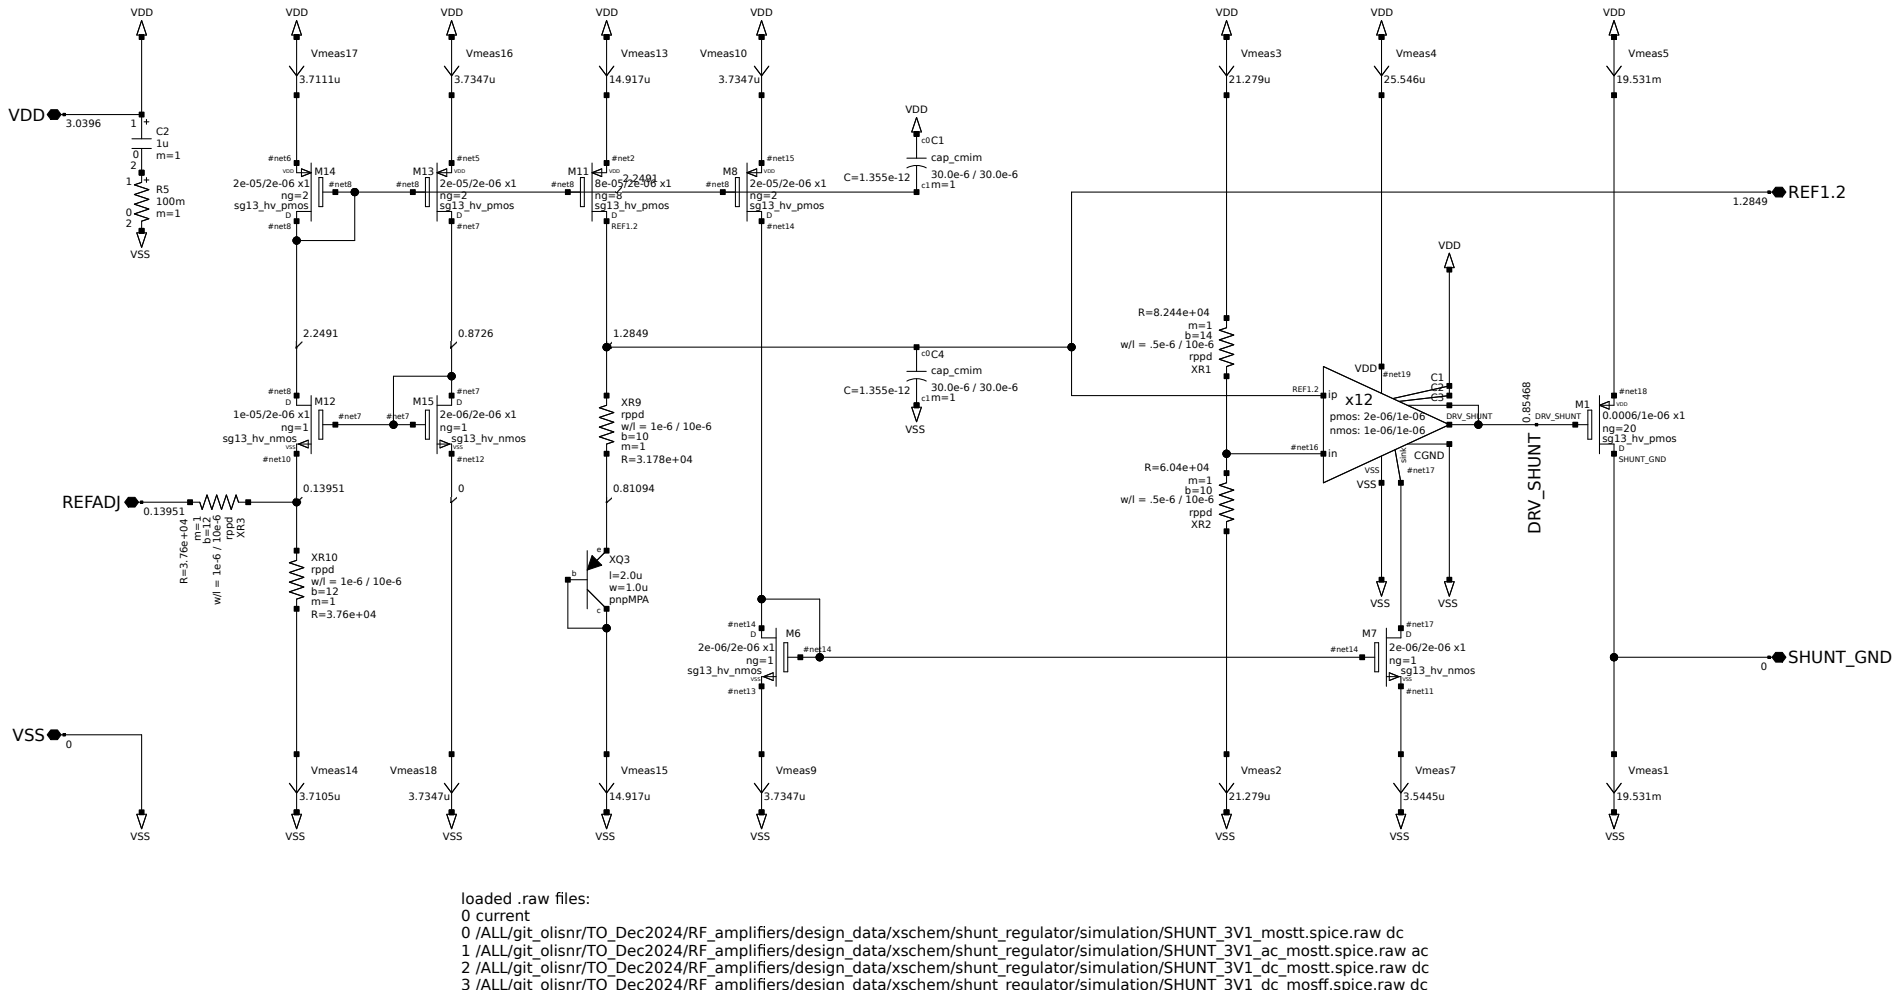
[picture p31: page 1]
VDD; VSS; VDDVDD; VSSVSS; DRV_SHUNT 0.85468; REFADJ; REF1.2 1.2849; SHUNT_GND 0; Vmeas13; sg13_hv_pmos D; REF1.2; #net2; #net8; Vmeas14; Vmeas15; pnpMPA; sg13_hv_nmos; #net10; #net7; #net5; #net6; Vmeas16; Vmeas17; Vmeas18; #net12; rppd; Vmeas7; #net17; #net11; #net14; Vmeas9; #net13; Vmeas10; #net15; SHUNT_GND; #net18; DRV_SHUNT; nmos: 1e-06/1e-06; pmos: 2e-06/1e-06 sink #net17VSS; #net16; #net19; CGND; w/l = .5e-6 / 10e-6 rppd XR1; w/l = .5e-6 / 10e-6 rppd XR2; Vmeas1; Vmeas2; Vmeas3; Vmeas4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

loaded .raw les:
0 current
0 /ALL/git_olisnr/TO_Dec2024/RF_ampliers/design_data/xschem/shunt_regulator/simulation/SHUNT_3V1_mostt.spice.raw dc
1 /ALL/git_olisnr/TO_Dec2024/RF_ampliers/design_data/xschem/shunt_regulator/simulation/SHUNT_3V1_ac_mostt.spice.raw ac
2 /ALL/git_olisnr/TO_Dec2024/RF_ampliers/design_data/xschem/shunt_regulator/simulation/SHUNT_3V1_dc_mostt.spice.raw dc
3 /ALL/git olisnr/TO Dec2024/RF ampliers/design data/xschem/shunt regulator/simulation/SHUNT 3V1 dc mosff.spice.raw dc
