IHP-GmbH/TO_Dec2024/RF_amplifiers/doc/build/latex/single-eps-converted-to.pdf

## VDD

## BGB540

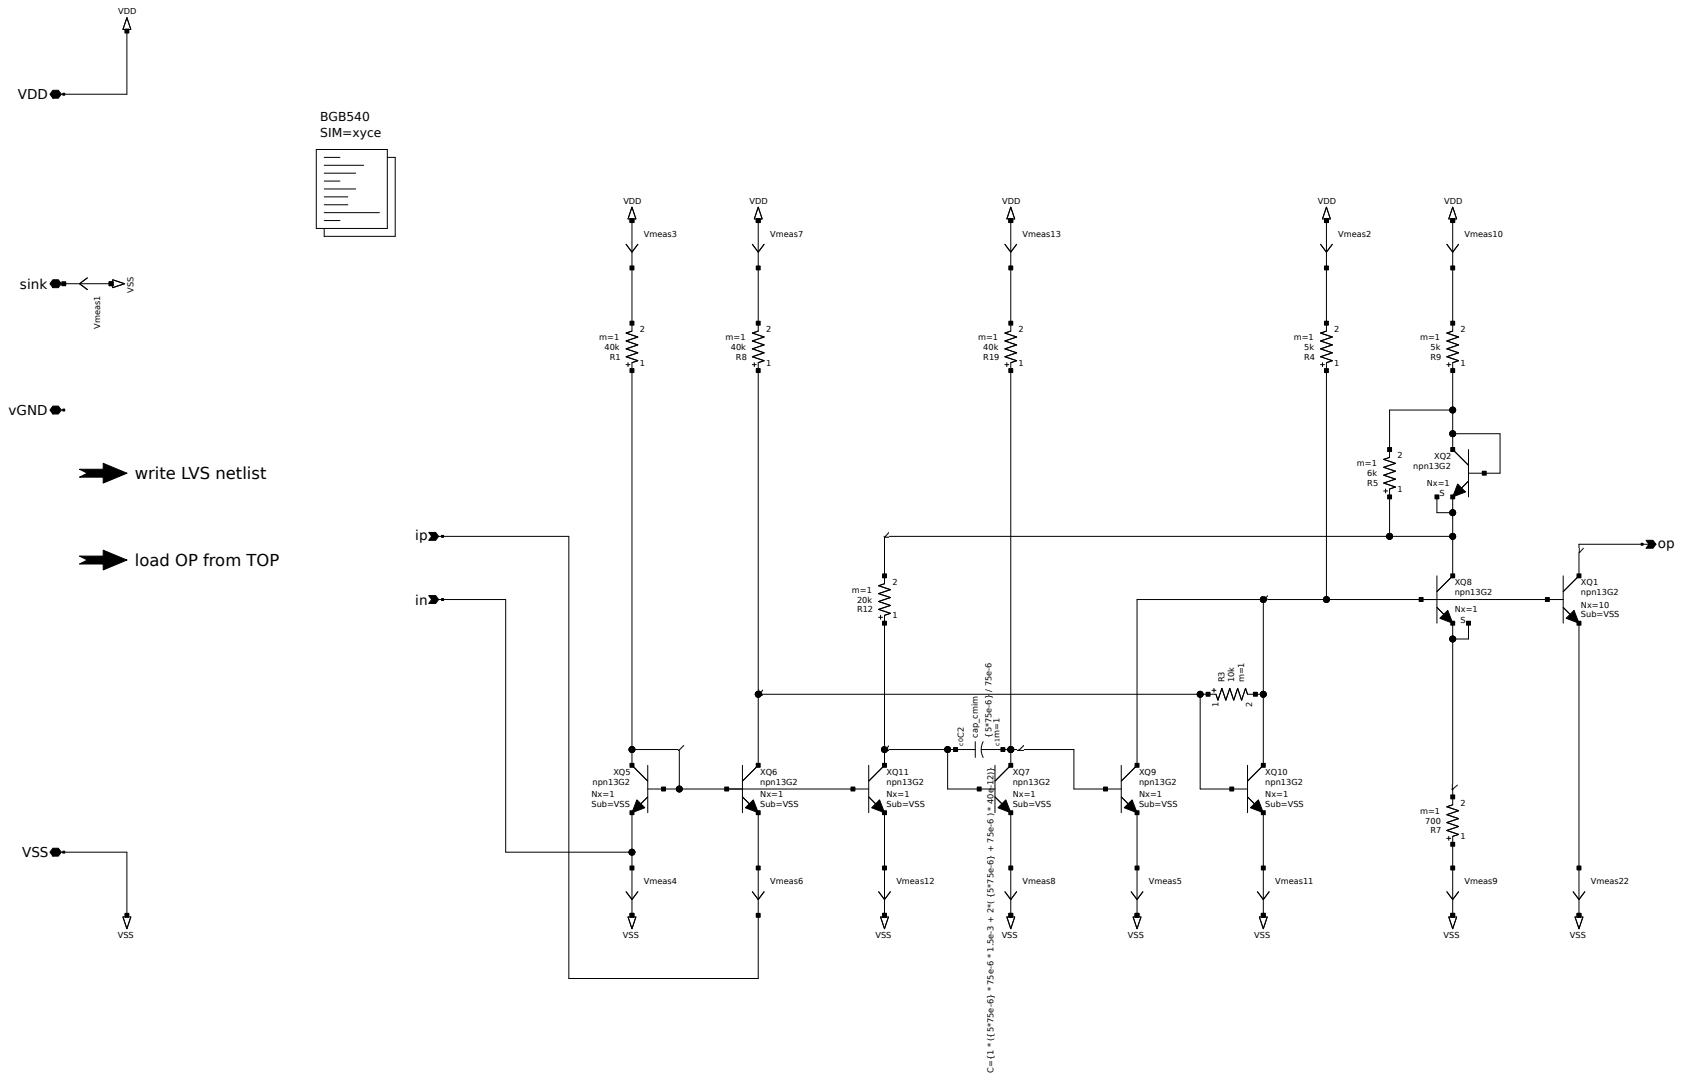
[picture p32: page 1]

load OP from TOP
