IHP-GmbH/TO_Dec2024/(commit log)

2024-12-06 changed the schematic names to match the GDS-cells
    and trow out not used schematics and tests
    [DiFF_0dBdB.sch, H_DiFF_15dB.sch, H_SiNGLE.sch, OTA33.sch, OTA33_BiAS.sch, OTA33_no_mim.sch, OTA33_test_xyce.sch, OTA33_test_xyce_no_mim.sch]
2026-04-13 Replace README.md with sample request info and projects table
    Agent-Logs-Url: https://github.com/IHP-GmbH/TO_Dec2024/sessions/5c292ac3-5c2d-44e0-bf47-b162e7b4e1bd
